sunflower-R/51-Flip-Clock/README.md

# 机械翻页时钟 | Mechanical Flip Clock

基于 STC89C52 单片机、DS1302 实时时钟与双步进电机驱动的机械翻页时钟实物。
分钟与时钟叶片独立翻转显示时间，集成 OLED 屏、矩阵键盘、闹钟功能与霍尔传感器零点校正。
## 仓库结构

```
├── LICENSE              # MIT 许可证
├── README.md            # 项目说明文档
├── .gitignore           # Git 忽略规则（Keil 编译文件等）
├── project/             # 核心源代码（Keil C51 工程）
│   ├── main.c           # 主程序
│   ├── ds1302.c/h       # DS1302 时钟驱动
│   ├── i2c.c/h          # I²C 总线及 OLED 驱动
│   ├── key.c/h          # 矩阵键盘扫描与蜂鸣器
│   ├── motor.c/h        # 步进电机控制、补偿、校正
│   └── oledchar.c/h     # OLED 字库
├── docs/                # 文档与演示资源
│   └── images/          # 实物照片与视频
└── hardware/            
│   └── proteus.jpg       # 电路原理图、接线图
└── simulation/
    └──单片机创新课设.pdsprj        # 电路原理图、接线图
```
## 硬件架构

- 主控：STC89C52（11.0592MHz）
- 时钟芯片：DS1302（三线SPI，掉电保护）
- 显示：I²C OLED 128×64（状态辅助显示）+ 机械翻页叶片（核心显示）
- 按键：4×4 矩阵键盘
- 驱动：双路 28BYJ-48 步进电机，8拍半步模式
- 传感器：分钟盘霍尔 ×1 + 时钟盘霍尔 ×1
- 蜂鸣器：无源蜂鸣器（闹钟旋律合成）

## 核心特性

- **步数补偿算法**：解决减速步进电机非整除传动比导致的走时漂移
- **霍尔传感器零点闭环校正**：分/时归零时刻低速寻零，消除长期累积误差
- **单定时器多任务调度**：1ms中断驱动电机步进/闹钟旋律/OLED闪烁并行执行
- **整点分时驱动**：优先分钟翻页，规避双电机同步启动致电压跌落
- **完整交互系统**：时钟设置、闹钟设置、电机手动调校三模式切换
- **闹钟功能**：独立设置界面，双音调旋律响铃，支持一键停止

## 引脚定义

| 功能 | 引脚 |
|---|---|
| DS1302 RST | P3.5 |
| DS1302 SCLK | P3.7 |
| DS1302 DSIO | P3.6 |
| OLED SCL | P1.0 |
| OLED SDA | P1.1 |
| 电机驱动 | P2（低4位分钟/高4位时钟） |
| 键盘行 | P1.7 - P1.4 |
| 键盘列 | P3.3 - P3.0 |
| 蜂鸣器 | P3.4 |
| 分钟霍尔 | P1.2 |
| 时钟霍尔 | P1.3 |
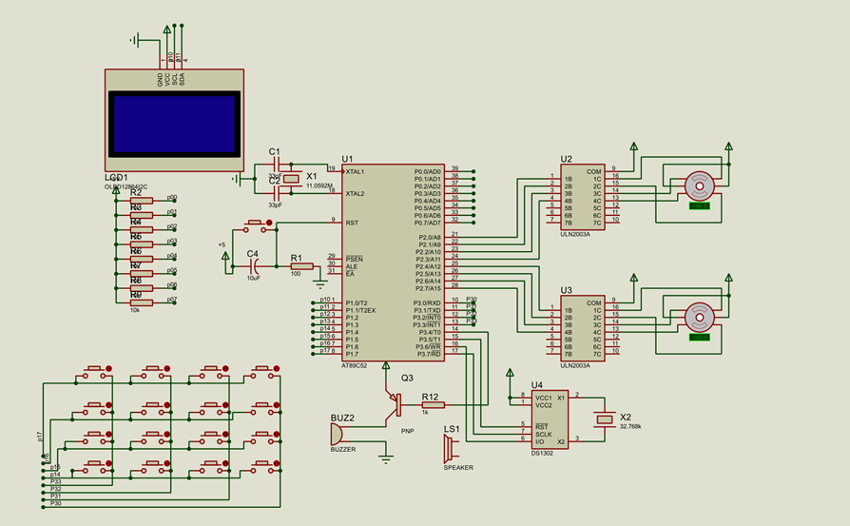
[picture p1: hardwares/proteus.jpg]
引脚连线图


## 步数补偿原理
28BYJ-48 步进电机经减速比后，驱动分钟盘翻一页（6°）理论需 68.27 步，
但电机只能执行整数步，每走 68 步产生约 0.27 步转角欠量。
补偿策略：
1. 基准驱动：每分钟 68 步
2. 周期补偿：每 3 分钟累积欠量达阈值，多补 5 步
3. 特殊点补偿：第 20 分钟叶片卡涩点额外注入 120 步
## 零点校正流程

为保证长期运行后分钟盘与时钟盘的绝对位置准确，系统在每次**分钟归零（00分）**和**小时归零（00时）**时自动触发零点校正：

1. **触发**：检测到归零时刻，开启校正状态，电机进入低速寻零模式。
2. **寸动寻零**：每 20ms（分钟电机）/ 30ms（时钟电机）步进一动，缓慢逼近零点。
3. **捕获**：霍尔传感器检测到零点磁铁时信号翻转，单片机立即捕捉。
4. **校准完成**：电机瞬间停止，位置计数器强制清零，校正结束。

> 过程采用状态机实现，避免阻塞主循环，不影响其他任务正常执行。
## 环境
- Keil C51
- STC-ISP 烧录工具
- 晶振 11.0592MHz

## 使用说明

| 按键 | 功能 |
|---|---|
| 按键1 | 进入/退出设置模式 |
| 按键2 | 切换设置项 |
| 按键3 | 数值+1 |
| 按键4 | 数值-1 |
| 按键5 | 保存设置 |
| 按键6-9 | 电机手动调校（按住连转） |
| 按键10 | 闹钟设置 |
| 按键13 | 闹钟开关/停止响铃 |

## 实物展示
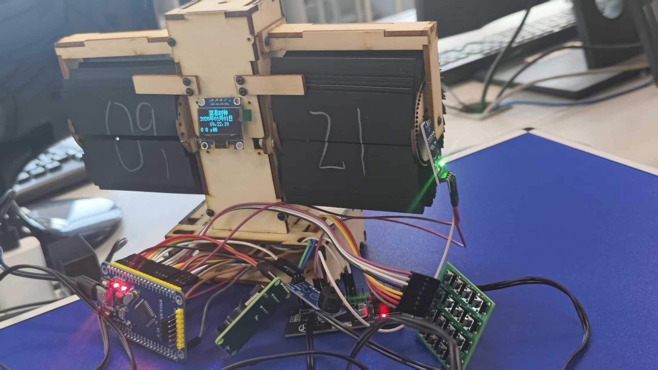
[picture p2: images/image.jpg]
图片


图片拍的比较少，由于本课程设计最后评为优秀，被老师收回，故图片并非最终效果

## 硬件材料清单
| 序号 | 名称 | 型号 / 规格 | 数量 | 主要参数 | 备注 |
| ---- | --- | --- | ---- | --- | --- |
| 1 | 单片机 | STC89C52RC | 1 | 8KB Flash，512B RAM | DIP-40 封装 |
| 2 | 晶振 | 11.0592MHz | 1 | 20pF 负载电容 | HC-49S 封装 |
| 3 | 晶振 | 32.768kHz | 1 | 12.5pF 负载电容 | 圆柱形封装 |
| 4 | 实时时钟芯片 | DS1302 | 1 | 涓流充电，31 字节非易失 RAM | DIP-8 封装 |
| 5 | OLED 显示屏 | 0.96 寸 | 1 | 128×64 分辨率，I2C 接口 | SSD1306 驱动 |
| 6 | 步进电机 | 28BYJ-48 | 2 | 5V 供电，1:64 减速比 | 四相五线制 |
| 7 | 电机驱动芯片 | ULN2003 | 2 | 7 路达林顿阵列 | DIP-16 封装 |
| 8 | 矩阵键盘 | 4×4 薄膜键盘 | 1 | 16 键配置 | 带引出引脚 |
| 9 | 蜂鸣器 | 无源蜂鸣器 | 1 | 5V 供电，3kHz 工作频率 | 电磁式 |
| 10 | 稳压芯片 | - | 1 | 输出 5V 电压，1A 输出电流 | SOT-223 封装 |
| 11 | 18650 电池 | 单节 3.7V | 3 | - | - |
## 协议

MIT License
