sunflower-R/51-Flip-Clock/(list of files, drawings)

Other design files:
simulation/单片机创新课设.pdsprj
