sunflower-R/51-Flip-Clock/project/oledchar.c

#include"oledchar.h"

//数组名前加code 可以增大数组的容量
uchar code zifu[16][32]=
      {{0x08,0x04,0xC3,0x12,0x26,0x8A,0xA2,0xAA,0xA4,0xA3,0x22,0x26,0xEA,0x02,0x02,0x00,
       0x00,0x00,0xFF,0x00,0x00,0x3F,0x24,0x24,0x24,0x3F,0x00,0x80,0xFF,0x00,0x00,0x00,},//简
	   {0x00,0x00,0x00,0x00,0x7F,0xC9,0x49,0x49,0x49,0x49,0x49,0x7F,0x00,0x00,0x00,0x00,
       0x00,0x08,0x04,0x42,0x23,0x12,0x8E,0x42,0x32,0x0E,0x42,0x82,0x42,0x3E,0x00,0x00,},//易
	   {0x00,0xFC,0x84,0x84,0x84,0xFC,0x00,0x10,0x10,0x10,0x10,0x10,0xFF,0x10,0x10,0x00,
       0x00,0x3F,0x10,0x10,0x10,0x3F,0x00,0x00,0x01,0x06,0x40,0x80,0x7F,0x00,0x00,0x00,},//时
	   {0x20,0x10,0x2C,0xE7,0x24,0x24,0x00,0xF0,0x10,0x10,0xFF,0x10,0x10,0xF0,0x00,0x00,
       0x01,0x01,0x01,0x7F,0x21,0x11,0x00,0x07,0x02,0x02,0xFF,0x02,0x02,0x07,0x00,0x00,},//钟
	   {0x00,0x20,0x18,0xC7,0x44,0x44,0x44,0x44,0xFC,0x44,0x44,0x44,0x44,0x04,0x00,0x00,
       0x04,0x04,0x04,0x07,0x04,0x04,0x04,0x04,0xFF,0x04,0x04,0x04,0x04,0x04,0x04,0x00,},//年
	   {0x00,0x00,0x00,0xFE,0x22,0x22,0x22,0x22,0x22,0x22,0x22,0x22,0xFE,0x00,0x00,0x00,
       0x80,0x40,0x30,0x0F,0x02,0x02,0x02,0x02,0x02,0x02,0x42,0x82,0x7F,0x00,0x00,0x00,},//月
	   {0x00,0x00,0x00,0xFE,0x82,0x82,0x82,0x82,0x82,0x82,0x82,0xFE,0x00,0x00,0x00,0x00,
       0x00,0x00,0x00,0xFF,0x40,0x40,0x40,0x40,0x40,0x40,0x40,0xFF,0x00,0x00,0x00,0x00,},//日
	   {0x00,0x00,0x00,0xBE,0x2A,0x2A,0x2A,0xEA,0x2A,0x2A,0x2A,0x3E,0x00,0x00,0x00,0x00,
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
	 {0x00,0x70,0x48,0x08,0x08,0x88,0x70,0x00,0x00,0x00,0x00,0x30,0x37,0x00,0x00,0x00,},//?
	 {0xC0,0x30,0xC8,0x28,0xE8,0x10,0xE0,0x00,0x07,0x18,0x27,0x28,0x2F,0x28,0x17,0x00,},//@
	 {0x00,0x00,0xC0,0x38,0xE0,0x00,0x00,0x00,0x20,0x3C,0x23,0x02,0x02,0x27,0x38,0x20,},//A
	 {0x08,0xF8,0x88,0x88,0x88,0x70,0x00,0x00,0x20,0x3F,0x20,0x20,0x20,0x11,0x0E,0x00,},//B
	 {0xC0,0x30,0x08,0x08,0x08,0x08,0x38,0x00,0x07,0x18,0x20,0x20,0x20,0x10,0x08,0x00,},//C
	 {0x08,0xF8,0x08,0x08,0x08,0x10,0xE0,0x00,0x20,0x3F,0x20,0x20,0x20,0x10,0x0F,0x00,},//D
	 {0x08,0xF8,0x88,0x88,0xE8,0x08,0x10,0x00,0x20,0x3F,0x20,0x20,0x23,0x20,0x18,0x00,},//E
	 {0x08,0xF8,0x88,0x88,0xE8,0x08,0x10,0x00,0x20,0x3F,0x20,0x00,0x03,0x00,0x00,0x00,},//F
	 {0xC0,0x30,0x08,0x08,0x08,0x38,0x00,0x00,0x07,0x18,0x20,0x20,0x22,0x1E,0x02,0x00,},//G
	 {0x08,0xF8,0x08,0x00,0x00,0x08,0xF8,0x08,0x20,0x3F,0x21,0x01,0x01,0x21,0x3F,0x20,},//H
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
	 {0x80,0x80,0x80,0x80,0x80,0xe0,0xc0,0x80,0x01,0x01,0x01,0x01,0x01,0x07,0x03,0x01,},//右箭头
	 {0x80,0xc0,0xe0,0x80,0x80,0x80,0x80,0x80,0x01,0x03,0x07,0x01,0x01,0x01,0x01,0x01,},//左箭头
	 
   };
