sunflower-R/51-Flip-Clock/(commit log)

2026-04-30 Add README for mechanical flip clock project
    Added detailed documentation for the mechanical flip clock project, including hardware architecture, core features, pin definitions, compensation principles, zero-point calibration process, environment setup, usage instructions, and licensing.
2026-04-30 Create 代码
